sichello/SmartPowerBar/Docs/Final_Spec/user_guide.docx

User Guide

1. Plug appliances into outlets.
2. Plug in and turn on power bar.
3. Hit ‘Set’ then use ‘Left/Right’ arrows to program local cost/kWh. Wait for unit to return to regular display.
4. Use ‘Left/Right’ arrows to toggle between display modes.
5. Press ‘Out’ to toggle between the outlet being displayed.
6. Hold ‘Out’ to reset the present outlet. Do this whenever a new appliance is plugged in.
