sichello/SmartPowerBar/Docs/Final_Spec/input_cond.pdf

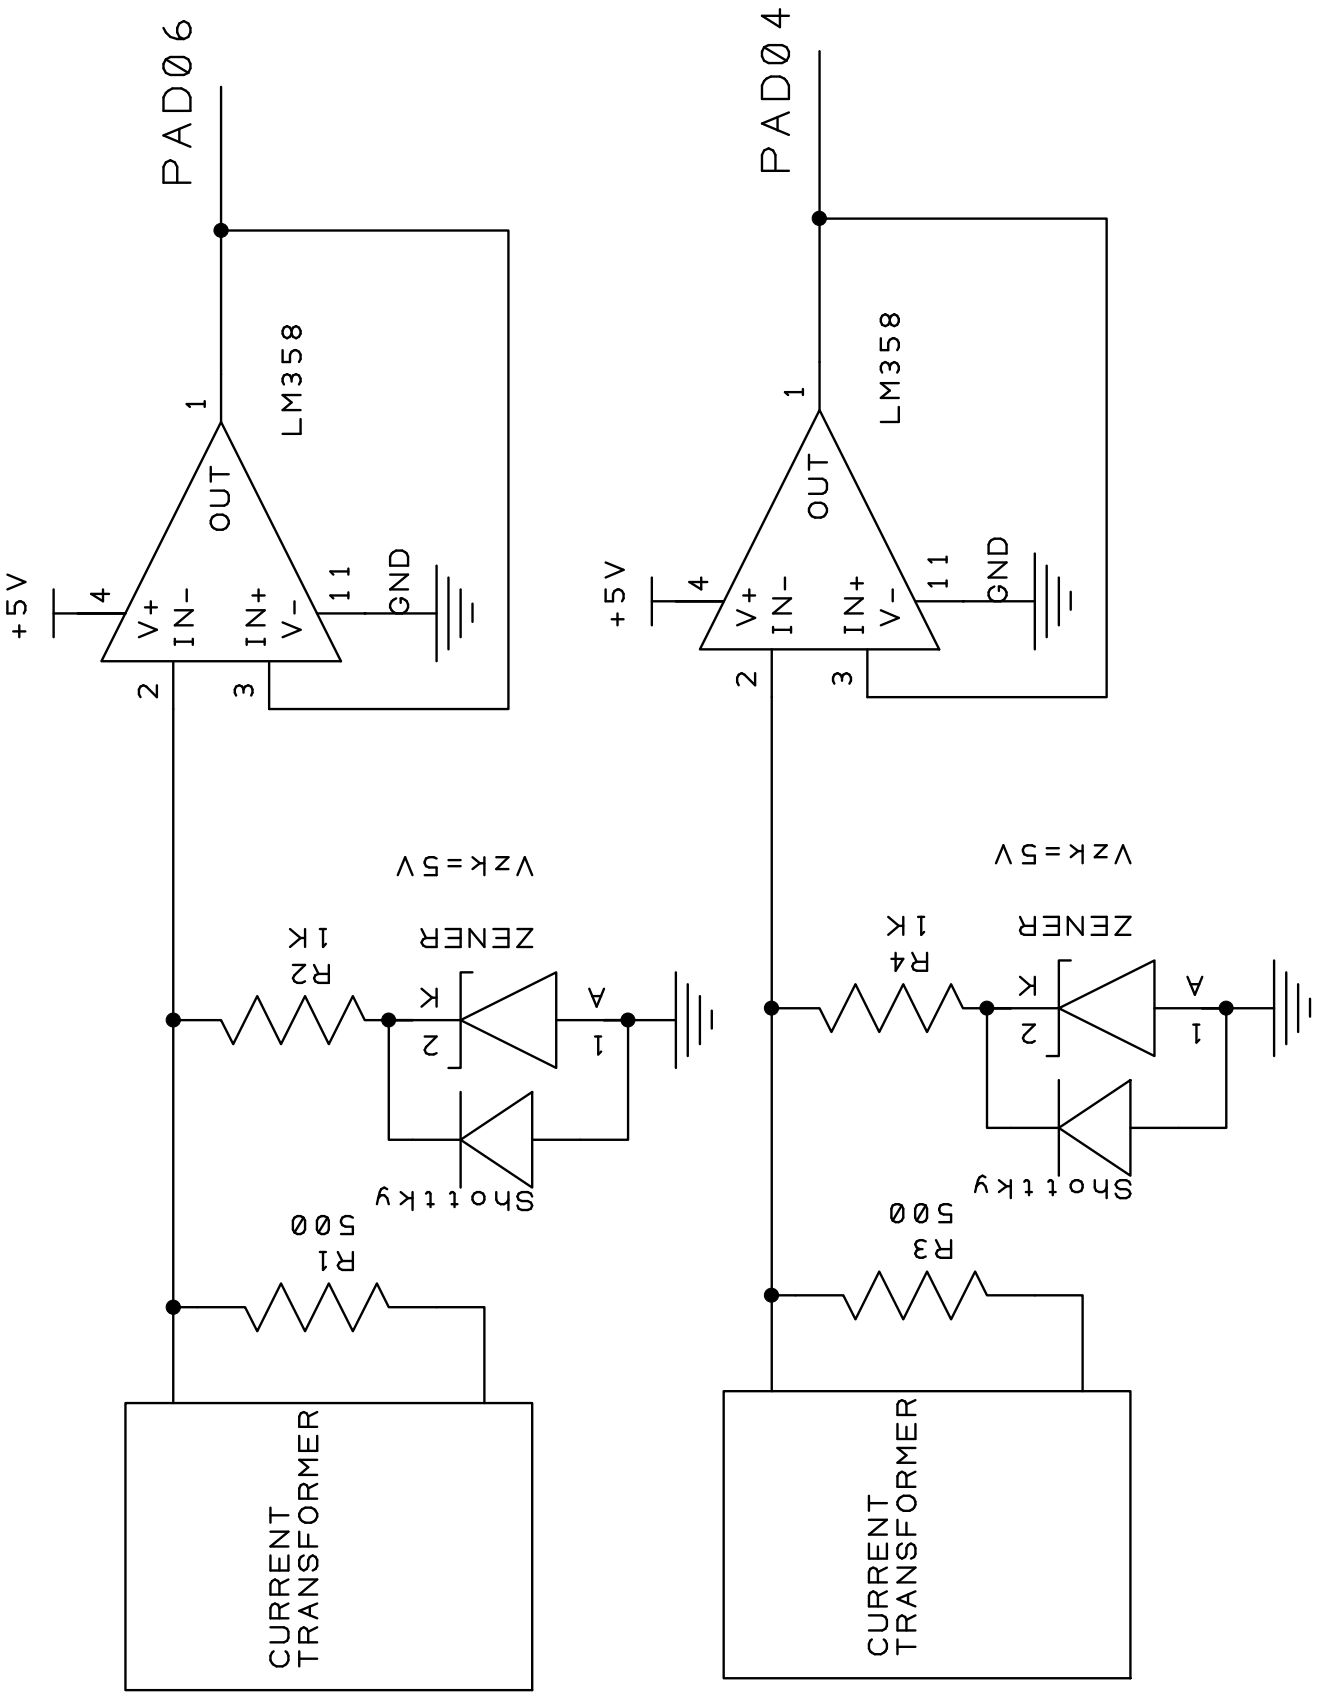
[picture p15: page 1]
