sichello/SmartPowerBar/Docs/Final_Spec/mian_circuit.pdf

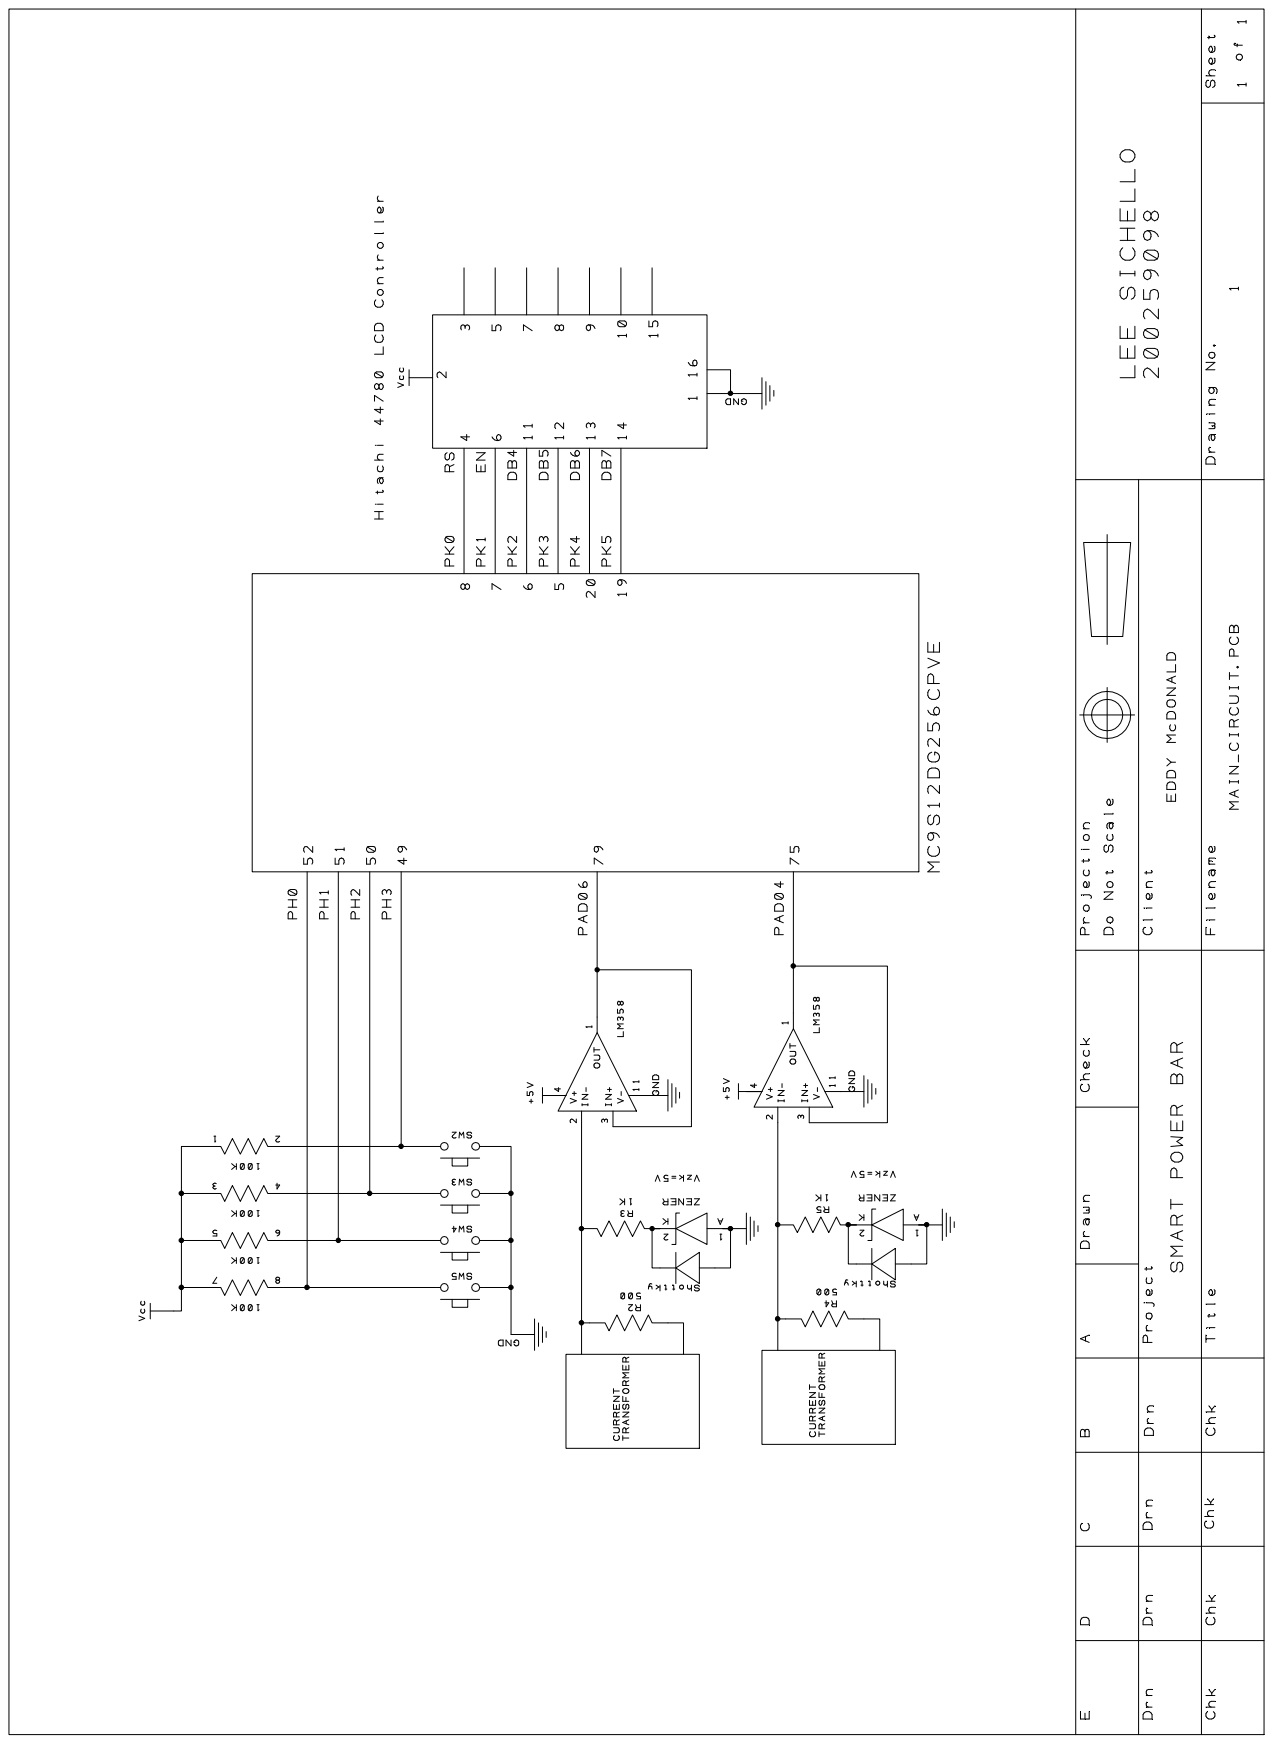
[picture p16: page 1]
