sichello/SmartPowerBar/Docs/Final_Spec/Schematic Design_ input_cond.pdf

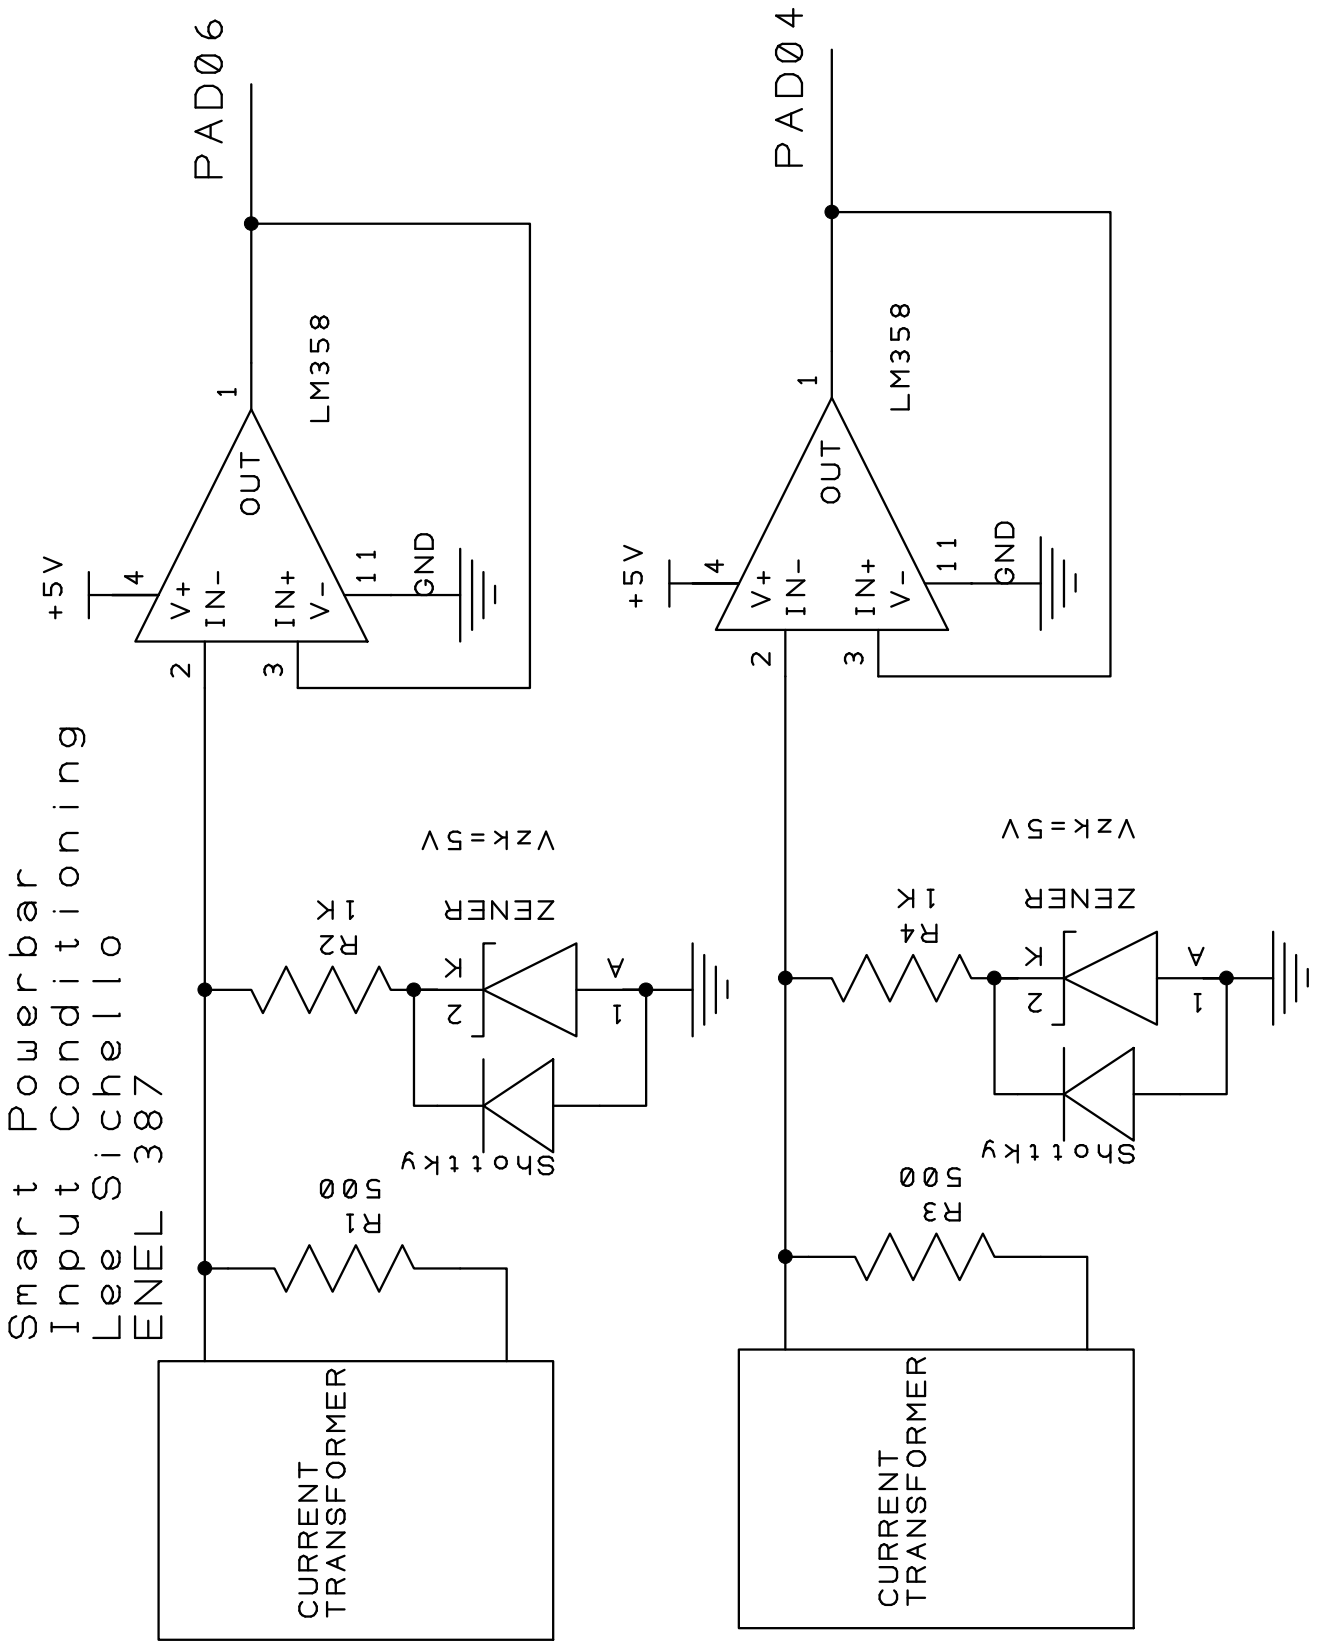
[picture p17: page 1]
