sichello/SmartPowerBar/Docs/Final_Spec/hrdwr_block.pdf

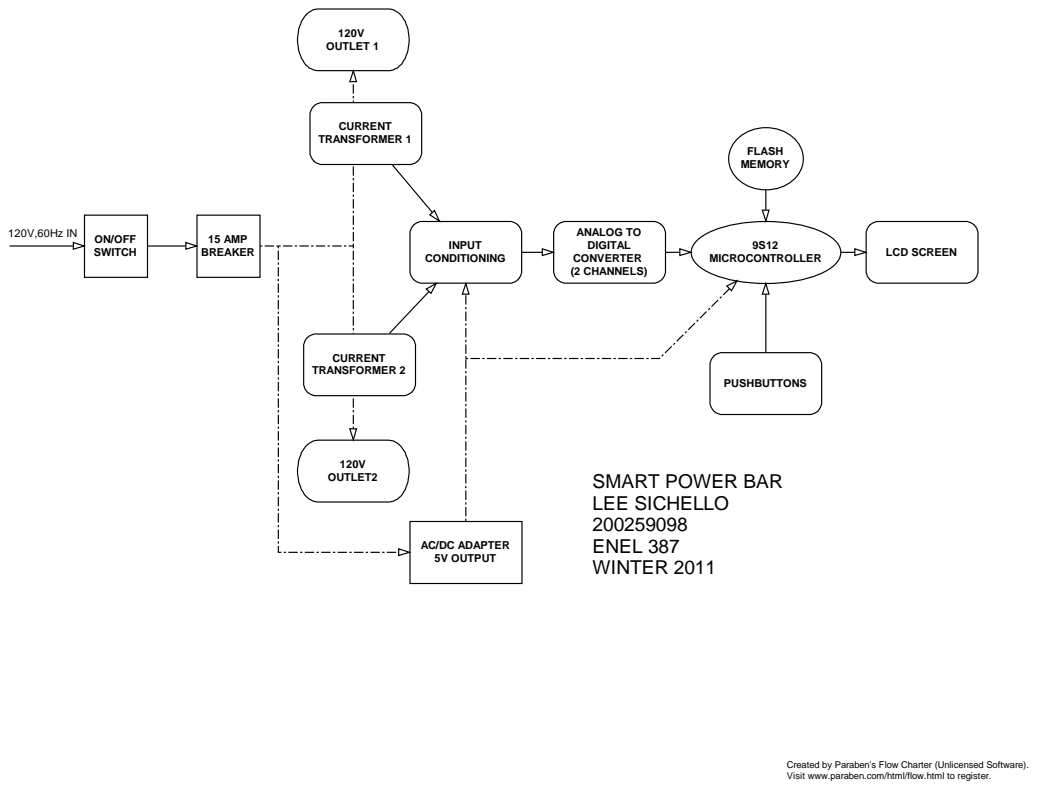
[picture p14: page 1]
INPUT CONDITIONING; PUSHBUTTONS; ANALOG TO DIGITAL CONVERTER (2 CHANNELS); MICROCONTROLLER; LCD SCREEN; FLASH MEMORY; ON/OFF SWITCH; 15 AMP BREAKER; 120V OUTLET 1; 120V OUTLET2; CURRENT TRANSFORMER 1; CURRENT TRANSFORMER 2; SMART POWER BAR LEE SICHELLO 200259098 ENEL 387 WINTER 2011

AC/DC ADAPTER
5V OUTPUT

Created by Paraben's Flow Charter (Unlicensed Software).
Visit www.paraben.com/html/flow.html to register.
